Aragya1642/Zoe2_PMS/3_Miscellaneous/Data_Logger/logs/bench/zoe2_log_20260417_154733_panels/temperatures.png

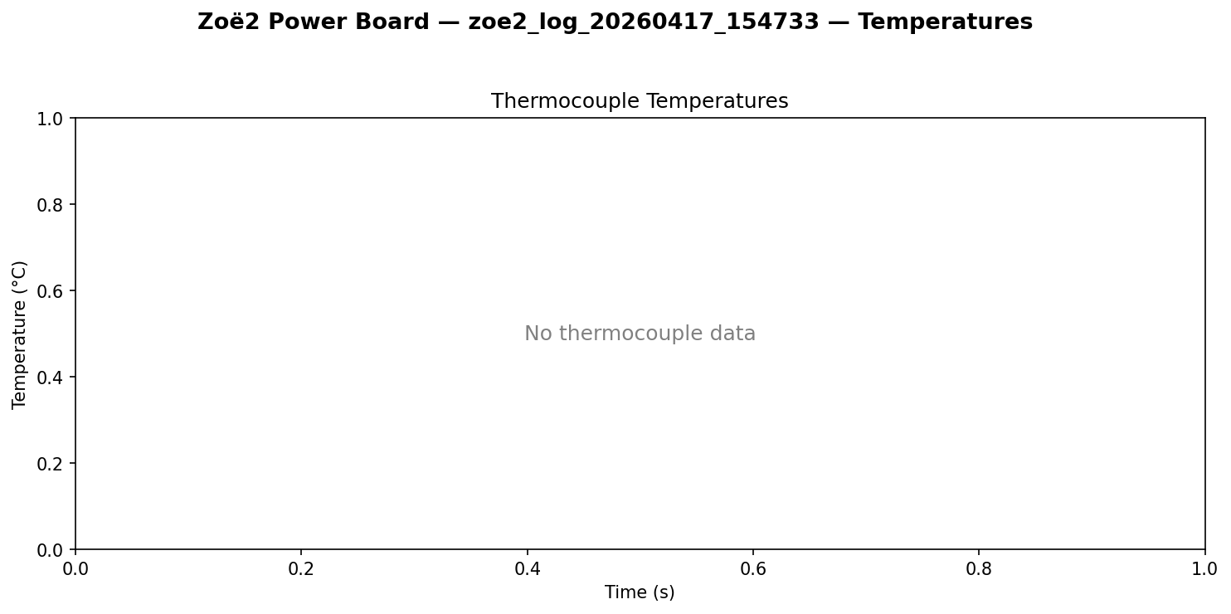
3_Miscellaneous/Data_Logger/logs/bench/zoe2_log_20260417_154733_panels/temperatures.png
