Aragya1642/Zoe2_PMS/3_Miscellaneous/Data_Logger/logs/day1/sun3_panels/currents.png

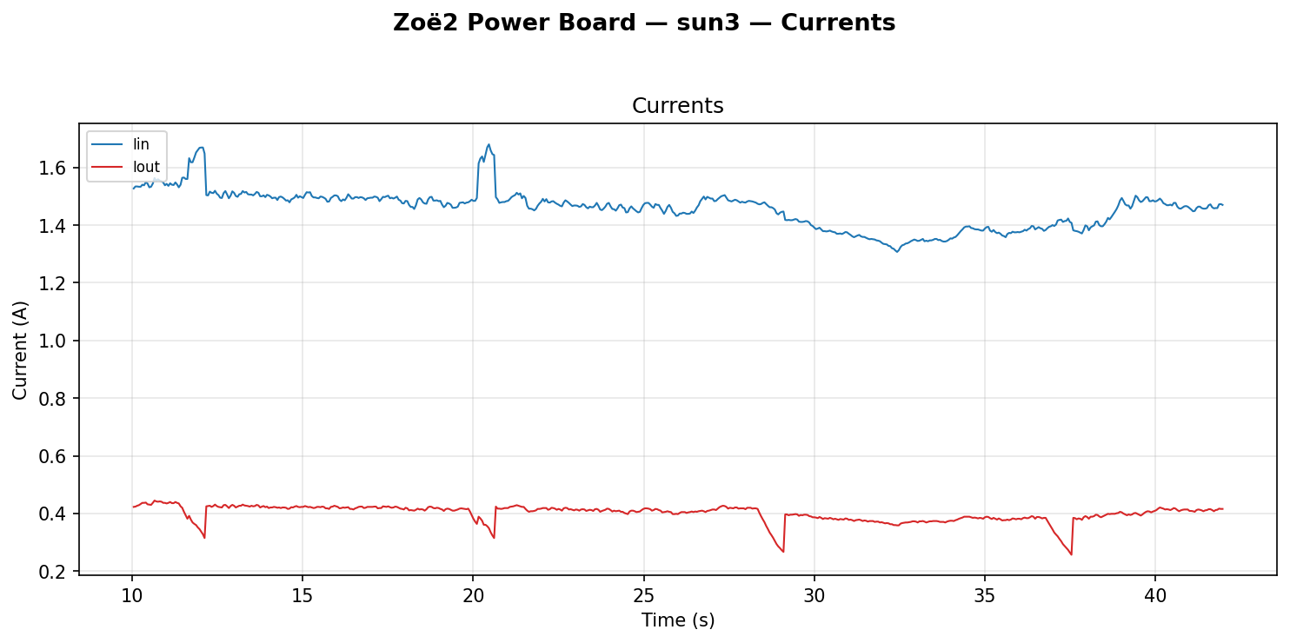
3_Miscellaneous/Data_Logger/logs/day1/sun3_panels/currents.png
