Aragya1642/Zoe2_PMS/2_Embedded/Zoe2_PMS_STM32G4/Core/Src/main.c

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
/* Includes ------------------------------------------------------------------*/
#include "main.h"

/* USER CODE BEGIN Includes */
#include <stdio.h>
#include <string.h>
#include <stdbool.h>
#include <math.h>
#include <ad5245.h>
#include <ads1115.h>
#include <max31855.h>
#include <bms.h>
#include <mppt.h>
#include <safety.h>
#include <ssd1306.h>
#include <ssd1306_fonts.h>
/* USER CODE END Includes */

/* USER CODE BEGIN PD */
/* Set to 1 to enable I2C bus scan at boot (adds ~400 ms delay) */
#define DEBUG_I2C_SCAN    0

/* Set to 1 to enable verbose BMS bring-up debug prints.
 * Keep enabled during hardware bring-up; turn off once BMS is trusted. */
#define DEBUG_BMS         1
/* USER CODE END PD */

FDCAN_HandleTypeDef hfdcan1;
FDCAN_HandleTypeDef hfdcan2;

I2C_HandleTypeDef hi2c2;

SPI_HandleTypeDef hspi1;

UART_HandleTypeDef huart3;

PCD_HandleTypeDef hpcd_USB_FS;

/* USER CODE BEGIN PV */
static const uint16_t channels[] = {
    ADS1115_MUX_SINGLE_0,
    ADS1115_MUX_SINGLE_1,
    ADS1115_MUX_SINGLE_2,
    ADS1115_MUX_SINGLE_3,
};

#define NUM_CHANNELS  (sizeof(channels) / sizeof(channels[0]))

/* ADS1115 runtime config (mux updated per-channel in read_adc) */
static ADS1115_Config cfg;

/* Latest thermocouple readings, cached for OLED and safety module.
 * Each TC has a value and a "last good" timestamp (HAL tick ms).
 * Readings older than TC_STALE_MS are considered stale.
 * Initial ts=0 means "never read" — treated as stale. */
#define TC_STALE_MS   3000u   /* 3x the 1000 ms read period */
static float    g_tc_C[3]     = { 0.0f, 0.0f, 0.0f };
static uint32_t g_tc_last[3]  = { 0, 0, 0 };
/* USER CODE END PV */

void SystemClock_Config(void);
static void MX_GPIO_Init(void);
static void MX_FDCAN1_Init(void);
static void MX_FDCAN2_Init(void);
static void MX_I2C2_Init(void);
static void MX_SPI1_Init(void);
static void MX_USB_PCD_Init(void);
static void MX_USART3_UART_Init(void);
/* USER CODE BEGIN PFP */
static void read_adc(float *v_in, float *i_in, float *v_out, float *i_out);
static void read_thermocouples(void);
static void print_telemetry(const MPPT_Data_t *m);
static void update_oled(const MPPT_Data_t *m);
static void boost_master_enable(bool on);
static void boost_slave_enable(bool on);
static void boost_disable_all(void);
#if DEBUG_BMS
static void bms_debug_summary(void);
#endif
/* USER CODE END PFP */

/* USER CODE BEGIN 0 */
// Allows for you to do printf statements
int _write(int file, char *ptr, int len) {
    HAL_UART_Transmit(&huart3, (uint8_t *)ptr, len, HAL_MAX_DELAY);
    return len;
}

/**
 * @brief Read all four ADS1115 channels and convert to engineering units.
 *
 * Channel mapping:
 *   AIN0 -> input current  (50x gain, 2.5 mOhm shunt)
 *   AIN1 -> output current (50x gain, 2.5 mOhm shunt)
 *   AIN2 -> input voltage  (1:20 divider)
 *   AIN3 -> output voltage (1:20 divider)
 *
 * On I2C error the corresponding output is left at 0.
 */
static void read_adc(float *v_in, float *i_in, float *v_out, float *i_out)
{
    int16_t raw;
    *v_in = *i_in = *v_out = *i_out = 0.0f;

    for (uint8_t ch = 0; ch < NUM_CHANNELS; ch++) {
        cfg.mux = channels[ch];
        if (ADS1115_ReadSingleShot(&hi2c2, ADS1115_ADDR_GND, &cfg, &raw) == HAL_OK) {
            float mv = ADS1115_ConvertToMillivolts(raw, cfg.pga);
            switch (ch) {
                case 0: *i_in  = (mv / 1000.0f / 50.0f) / 0.0025f; break;
                case 1: *i_out = (mv / 1000.0f / 50.0f) / 0.0025f; break;
                case 2: *v_in  = mv / 1000.0f * 20.0f;             break;
                case 3: *v_out = mv / 1000.0f * 20.0f;             break;
            }
        }
    }
}

/**
 * @brief Read all three MAX31855 thermocouples and update the cache.
 *
 * Wiring note (historical): CS1 drives J_Temp3, CS2 drives J_Temp2,
 * CS3 drives J_Temp1. This helper presents them as TC1/TC2/TC3 in
 * the cache to match physical labels.
 *
 * On success, the reading and HAL tick are written to g_tc_C[] and
 * g_tc_last[]. On SPI error or sensor fault the entry is left alone
 * — update_oled() will age out via TC_STALE_MS and display "---".
 */
static void read_thermocouples(void)
{
    /* Mapping: cache index -> (GPIO port, pin) */
    static const struct {
        GPIO_TypeDef *port;
        uint16_t      pin;
    } tc_cs[3] = {
        { GPIOD,                 THERMO_CS3_Pin },   /* TC1 */
        { GPIOD,                 THERMO_CS2_Pin },   /* TC2 */
        { THERMO_CS1_GPIO_Port,  THERMO_CS1_Pin },   /* TC3 */
    };

    uint32_t now = HAL_GetTick();
    MAX31855_Data tc;

    for (uint8_t i = 0; i < 3; i++) {
        if (MAX31855_Read(&hspi1, tc_cs[i].port, tc_cs[i].pin, &tc) == HAL_OK
            && !tc.fault) {
            g_tc_C[i]    = tc.tc_temp;
            g_tc_last[i] = now;
            printf("TC%u: %.2f C  |  CJ%u: %.2f C\r\n",
                   i + 1, tc.tc_temp, i + 1, tc.cj_temp);
        } else {
            printf("TC%u: read failed or faulted\r\n", i + 1);
        }
    }
}

/**
 * @brief Print one MPPT telemetry record to the debug UART.
 */
static void print_telemetry(const MPPT_Data_t *m)
{
    printf("MPPT: tick=%lu  wiper=%u  state=%d  Pin=%.2fW  Vin=%.2fV  Iin=%.3fA\r\n",
           HAL_GetTick(), m->wiper, m->state,
           m->power_W, m->in_voltage_V, m->in_current_A);
    printf("      Vout=%.2fV  Iout=%.3f A\r\n",
           m->out_voltage_V, m->out_current_A);
    printf("----\r\n");
}

/**
 * @brief Render telemetry to a dual-color SSD1306 OLED.
 *
 * Display physically has yellow pixels on rows 0-15 and white/blue
 * pixels on rows 16-63. Layout exploits this split:
 *
 *   YELLOW BAND (y=0..15):
 *     y=3    "PMS         TRACK"  Font_7x10 (18 chars, 10px tall)
 *            — when safety trips, the tag replaces the MPPT state.
 *
 *   WHITE AREA (y=16..63):
 *     y=18   "Pin  : 39.3 W"
 *     y=27   "Pout : 29.0 W"
 *     y=36   "Eff  :  78 %"
 *     y=45   "TC1:45 TC2:42 TC3:68"
 *     y=54   "W:230"
 *
 * Frame push takes ~20-25 ms @ 400 kHz I2C. Call no faster than 500 ms.
 */
static void update_oled(const MPPT_Data_t *m)
{
    static const char *state_names[] = { "IDLE", "TRACK", "SCAN", "FAULT" };
    char buf[24];

    ssd1306_Fill(Black);

    /* ── YELLOW BAND: project + state (or safety tag if faulted) ─ */
    const char *safety_tag = Safety_FaultTag();
    const char *header = (safety_tag[0] != '\0')
                       ? safety_tag
                       : ((m->state <= 3) ? state_names[m->state] : "???");

    /* Font_7x10 is 7px wide → 18 chars fit in 128px width.
     * Pad so state/tag lands right-justified in the yellow strip. */
    snprintf(buf, sizeof(buf), "PMS%*s", 15 - (int)strlen(header), header);
    ssd1306_SetCursor(0, 3);
    ssd1306_WriteString(buf, Font_7x10, White);

    /* ── WHITE AREA: power, efficiency, temperatures ────────────── */

    /* Input power */
    snprintf(buf, sizeof(buf), "Pin  : %5.1f W", m->power_W);
    ssd1306_SetCursor(0, 18);
    ssd1306_WriteString(buf, Font_6x8, White);

    /* Output power */
    float p_out = m->out_voltage_V * m->out_current_A;
    snprintf(buf, sizeof(buf), "Pout : %5.1f W", p_out);
    ssd1306_SetCursor(0, 27);
    ssd1306_WriteString(buf, Font_6x8, White);

    /* Efficiency */
    int eff = 0;
    if (m->power_W > 0.5f) {
        float e = 100.0f * p_out / m->power_W;
        if (e < 0.0f)   e = 0.0f;
        if (e > 150.0f) e = 150.0f;
        eff = (int)e;
    }
    snprintf(buf, sizeof(buf), "Eff  :  %3d %%", eff);
    ssd1306_SetCursor(0, 36);
    ssd1306_WriteString(buf, Font_6x8, White);

    /* Three thermocouples — show "---" if reading is stale or never taken */
    uint32_t now = HAL_GetTick();
    char tc_s[3][4];  /* "-45" or "---" */
    for (uint8_t i = 0; i < 3; i++) {
        bool never = (g_tc_last[i] == 0);
        bool stale = (!never) && (now - g_tc_last[i] > TC_STALE_MS);
        if (never || stale) {
            snprintf(tc_s[i], sizeof(tc_s[i]), "---");
        } else {
            snprintf(tc_s[i], sizeof(tc_s[i]), "%3d", (int)g_tc_C[i]);
        }
    }
    snprintf(buf, sizeof(buf), "T1:%s T2:%s T3:%s",
             tc_s[0], tc_s[1], tc_s[2]);
    ssd1306_SetCursor(0, 45);
    ssd1306_WriteString(buf, Font_6x8, White);

    /* Wiper bottom line */
    snprintf(buf, sizeof(buf), "W:%3u", m->wiper);
    ssd1306_SetCursor(0, 54);
    ssd1306_WriteString(buf, Font_6x8, White);

    ssd1306_UpdateScreen();
}

/**
 * @brief Enable or disable the master boost converter stage.
 *
 * SD_Master  HIGH = enabled (device active)
 * SWEN_Master HIGH = switching enabled
 *
 * Both must be HIGH for the stage to deliver power.
 */
static void boost_master_enable(bool on)
{
    GPIO_PinState state = on ? GPIO_PIN_SET : GPIO_PIN_RESET;
    HAL_GPIO_WritePin(GPIOD, SD_Master_Pin,   state);
    HAL_GPIO_WritePin(GPIOD, SWEN_Master_Pin, state);
}

/**
 * @brief Enable or disable the slave boost converter stage.
 */
static void boost_slave_enable(bool on)
{
    GPIO_PinState state = on ? GPIO_PIN_SET : GPIO_PIN_RESET;
    HAL_GPIO_WritePin(GPIOD, SD_Slave_Pin,   state);
    HAL_GPIO_WritePin(GPIOD, SWEN_Slave_Pin, state);
}

/**
 * @brief Force both boost stages off. Safe default and fault response.
 */
static void boost_disable_all(void)
{
    boost_master_enable(false);
    boost_slave_enable(false);
}

#if DEBUG_BMS
/**
 * @brief Dump parsed BMS telemetry to the UART for bring-up verification.
 *
 * Prints a two-line summary: pack-level info (V/I/SoC) and per-cell
 * statistics (min/max/spread). Only prints if the BMS has produced at
 * least one valid parse (@c valid == true).
 */
static void bms_debug_summary(void)
{
    const BMS_Data_t *b = BMS_GetData();
    if (!b->valid) {
        printf("BMS: no data yet  rx_total=%lu\r\n", b->rx_total);
        return;
    }

    printf("BMS pack: V=%.2fV  I=%.2fA  SoC=%.1f%%  age=%lu ms\r\n",
           b->total0.pack_voltage_V,
           b->total0.current_A,
           b->total0.soc_pct,
           HAL_GetTick() - b->last_update_ms);

    printf("     max=%umV (c%u)  min=%umV (c%u)  diff=%umV  cells=%u\r\n",
           b->cell_stats.max_mv, b->cell_stats.max_cell,
           b->cell_stats.min_mv, b->cell_stats.min_cell,
           b->cell_stats.diff_mv,
           b->status2.cell_number);
}
#endif
/* USER CODE END 0 */

/**
  * @brief  The application entry point.
  * @retval int
  */
int main(void)
{

  /* MCU Configuration--------------------------------------------------------*/

  /* Reset of all peripherals, Initializes the Flash interface and the Systick. */
  HAL_Init();

  /* Configure the system clock */
  SystemClock_Config();

  /* Initialize all configured peripherals */
  MX_GPIO_Init();
  MX_FDCAN1_Init();
  MX_FDCAN2_Init();
  MX_I2C2_Init();
  MX_SPI1_Init();
  MX_USB_PCD_Init();
  MX_USART3_UART_Init();
  /* USER CODE BEGIN 2 */
  printf("alive\r\n");

#if DEBUG_I2C_SCAN
  printf("Scanning I2C2...\r\n");
  for (uint8_t addr = 0x08; addr < 0x78; addr++) {
      if (HAL_I2C_IsDeviceReady(&hi2c2, (addr << 1), 3, 10) == HAL_OK) {
          printf("  Found device at 0x%02X\r\n", addr);
      }
  }
  printf("Done.\r\n");
#endif

  /* ---- ADS1115 configuration ---- */
  cfg.mux       = ADS1115_MUX_SINGLE_0;
  cfg.pga       = ADS1115_PGA_4_096V;
  cfg.mode      = ADS1115_MODE_SINGLE;
  cfg.dr        = ADS1115_DR_128SPS;
  cfg.comp_mode = ADS1115_COMP_MODE_TRAD;
  cfg.comp_pol  = ADS1115_COMP_POL_LOW;
  cfg.comp_lat  = ADS1115_COMP_LAT_OFF;
  cfg.comp_que  = ADS1115_COMP_QUE_DISABLE;

  /* ---- Boost converters start in OFF state ----
   * Explicit safe default: both master and slave disabled at boot.
   * The safety module owns enable/disable from this point forward;
   * boost_master_enable() is called once below after init, then only
   * toggled in response to safety state transitions in the main loop.
   */
  boost_disable_all();
  HAL_Delay(10);

  /* ---- Initialize BMS driver (BEFORE HAL_FDCAN_Start) ----
   * BMS_Init configures an extended-ID filter and enables the RX FIFO0
   * new-message notification. Both calls are only valid while FDCAN is
   * in init mode, so this MUST precede HAL_FDCAN_Start().
   */
  if (BMS_Init(&hfdcan2) != HAL_OK) {
      printf("BMS_Init FAILED\r\n");
  } else {
      printf("BMS initialized\r\n");
  }

  /* ---- Start FDCAN2 ---- */
  if (HAL_FDCAN_Start(&hfdcan2) != HAL_OK) {
      printf("FDCAN2 start FAILED\r\n");
  } else {
      printf("FDCAN2 started OK\r\n");
      /* Send initial wake-up query — BMS begins autonomous broadcast after this */
      if (BMS_SendQuery() != HAL_OK) {
          printf("BMS wake-up query FAILED\r\n");
      } else {
          printf("BMS wake-up query sent\r\n");
      }
  }

  /* ---- Initialize MPPT ---- */
  MPPT_Config_t mppt_cfg = {
      .wiper_min     = 112,
      .wiper_max     = 255,
      .po_step       = 1,
      .scan_step     = 5,
      .scan_interval = MPPT_SCAN_INTERVAL_DEFAULT,
  };
  MPPT_Init(&mppt_cfg);
  printf("MPPT initialized\r\n");

  /* ---- Initialize Safety ---- */
  Safety_Config_t safety_cfg = {
      .vin_max_V      = SAFETY_DEFAULT_VIN_MAX_V,
      .vin_min_V      = SAFETY_DEFAULT_VIN_MIN_V,
      .iin_max_A      = SAFETY_DEFAULT_IIN_MAX_A,
      .vout_max_V     = SAFETY_DEFAULT_VOUT_MAX_V,
      .iout_max_A     = SAFETY_DEFAULT_IOUT_MAX_A,
      .temp_max_C     = SAFETY_DEFAULT_TEMP_MAX_C,
      .tc_stale_ms    = SAFETY_DEFAULT_TC_STALE_MS,
      .bms_timeout_ms = SAFETY_DEFAULT_BMS_TIMEOUT_MS,
      .recovery_ms    = SAFETY_DEFAULT_RECOVERY_MS,
  };
  Safety_Init(&safety_cfg);
  printf("Safety initialized\r\n");

  /* ---- Initialize OLED ---- */
  ssd1306_Init();
  ssd1306_Fill(Black);
  ssd1306_SetCursor(10, 24);
  ssd1306_WriteString("Booting...", Font_11x18, White);
  ssd1306_UpdateScreen();
  HAL_Delay(500);
  printf("OLED initialized\r\n");

  /* ---- All subsystems ready — enable master boost stage ----
   * Main loop will disable the boost if safety reports SHUTDOWN
   * and re-enable it when safety returns to SAFE after recovery.
   */
  boost_master_enable(true);
  printf("Boost master enabled\r\n");

  /* USER CODE END 2 */

  /* Infinite loop */
  /* USER CODE BEGIN WHILE */
  while (1)
  {
    /* USER CODE END WHILE */

    /* USER CODE BEGIN 3 */
      /* ── Heartbeat LEDs ───────────────────────────────────────── */
      HAL_GPIO_TogglePin(GPIOG, CAN_NMT_STATUS_Pin);
      HAL_GPIO_TogglePin(GPIOG, CAN_ERROR_STATE_Pin);

      /* ── MPPT + ADC + safety check + telemetry (every 50 ms) ──── */
      static uint32_t last_mppt = 0;
      if (HAL_GetTick() - last_mppt >= 50) {
          last_mppt = HAL_GetTick();

          float v_in, i_in, v_out, i_out;
          read_adc(&v_in, &i_in, &v_out, &i_out);

          /* Pull latest BMS data. last_update_ms and valid are updated
           * asynchronously from the FDCAN RX ISR; 32-bit reads are atomic
           * on STM32G4 so no critical section is needed. */
          const BMS_Data_t *bms = BMS_GetData();

          /* Safety evaluates *before* MPPT so we never drive the pot
           * with a value from a cycle that turned out to be faulted. */
          Safety_Inputs_t si = {
              .v_in          = v_in,
              .i_in          = i_in,
              .v_out         = v_out,
              .i_out         = i_out,
              .tc_C          = g_tc_C,
              .tc_last       = g_tc_last,
              .bms_last_tick = bms->last_update_ms,
              .bms_enabled   = bms->valid,  /* auto-enables on first frame */
          };
          Safety_Response_t rsp = Safety_Check(&si);

          if (rsp == SAFETY_SHUTDOWN) {
              /* Kill the boost and skip MPPT. The algorithm state is
               * preserved — when we recover, P&O picks up where it left
               * off rather than starting fresh. */
              boost_disable_all();
          } else {
              /* Re-enable on the first cycle after recovery; cheap
               * GPIO write so calling it every cycle is fine. */
              boost_master_enable(true);

              uint8_t wiper = MPPT_Step(v_in, i_in, v_out, i_out);
              AD5245_SetWiper(&hi2c2, AD5245_ADDR_AD0_LOW, wiper);
          }

          print_telemetry(MPPT_GetData());
      }

      /* ── OLED update (every 500 ms) ───────────────────────────── */
      static uint32_t last_oled = 0;
      if (HAL_GetTick() - last_oled >= 500) {
          last_oled = HAL_GetTick();
          update_oled(MPPT_GetData());
      }

      /* ── Thermocouple reads (every 1 s) ───────────────────────── */
      static uint32_t last_tc = 0;
      if (HAL_GetTick() - last_tc >= 1000) {
          last_tc = HAL_GetTick();
          read_thermocouples();

    	  /* Keep fake cache fresh so TC_STALE never trips */
//		  uint32_t now = HAL_GetTick();
//		  g_tc_C[0]    = 25.0f;
//		  g_tc_last[0] = now;
//		  g_tc_C[1]    = 25.0f;
//		  g_tc_last[1] = now;
//		  g_tc_C[2]    = 25.0f;
//		  g_tc_last[2] = now;
      }

      /* ── BMS Keepalive (every 2.5 s) ──────────────────────────── */
      static uint32_t last_bms = 0;
      if (HAL_GetTick() - last_bms >= BMS_KEEPALIVE_MS) {
          last_bms = HAL_GetTick();
          HAL_StatusTypeDef s = BMS_SendQuery();
#if DEBUG_BMS
          printf("BMS query: %s\r\n", (s == HAL_OK) ? "OK" : "FAIL");
#else
          if (s != HAL_OK) { printf("BMS_SendQuery FAILED\r\n"); }
#endif
      }

#if DEBUG_BMS
      /* ── BMS liveness + parsed-data dump (every 2 s) ──────────── */
      static uint32_t last_bms_dbg = 0;
      if (HAL_GetTick() - last_bms_dbg >= 2000) {
          last_bms_dbg = HAL_GetTick();

          const BMS_Data_t *b = BMS_GetData();
          uint32_t age = b->last_update_ms
                       ? (HAL_GetTick() - b->last_update_ms) : 0;
          printf("BMS: valid=%d  rx_total=%lu  age=%lu ms\r\n",
                 b->valid, b->rx_total, age);

          bms_debug_summary();
      }
#endif

  }

  /* USER CODE END 3 */
}

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
/* USER CODE BEGIN 4 */

/**
 * @brief FDCAN RX FIFO0 callback — HAL requires this at application
 *        level. Delegates to the appropriate driver based on which
 *        FDCAN peripheral triggered the interrupt.
 */
void HAL_FDCAN_RxFifo0Callback(FDCAN_HandleTypeDef *hfdcan,
                               uint32_t RxFifo0ITs)
{
    if (hfdcan == &hfdcan2) {
        BMS_RxCallback(hfdcan);
    }
    /* FDCAN1 (CANopen) RX handler would go here when added */
}

/* USER CODE END 4 */
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
