Aragya1642/Zoe2_PMS/2_Embedded/Zoe2_PMS_STM32G4/Zoe2_PMS_STM32G4.ioc

Mcu.UserName=STM32G473QETx
PA11.Signal=USB_DM
PA12.Signal=USB_DP
PA13.Signal=SYS_JTMS-SWDIO
PA14.Signal=SYS_JTCK-SWCLK
PA7.Signal=SPI1_MOSI
PA8.Signal=I2C2_SDA
PB12.Signal=FDCAN2_RX
PB4.Signal=SPI1_MISO
PB6.Signal=FDCAN2_TX
PB9.Signal=USART3_TX
PC10.Signal=GPIO_Input
PC11.Signal=USART3_RX
PC4.Signal=I2C2_SCL
PC8.GPIO_Label=THERMO_CS1
PC8.Signal=GPIO_Output
PD0.Signal=FDCAN1_RX
PD1.Signal=FDCAN1_TX
PD2.GPIO_Label=THERMO_CS2
PD2.Signal=GPIO_Output
PD3.GPIO_Label=THERMO_CS3
PD3.Signal=GPIO_Output
PD4.GPIO_Label=SWEN_Master
PD4.Signal=GPIO_Output
PD5.GPIO_Label=SWEN_Slave
PD5.Signal=GPIO_Output
PD6.GPIO_Label=SD_Master
PD6.Signal=GPIO_Output
PD7.GPIO_Label=SD_Slave
PD7.Signal=GPIO_Output
PE0.Signal=GPIO_Output
PE1.Signal=GPIO_Output
PE2.Signal=GPIO_Output
PE3.Signal=GPIO_Output
PE4.Signal=GPIO_Input
PF0-OSC_IN.Signal=RCC_OSC_IN
PF1-OSC_OUT.Signal=RCC_OSC_OUT
PF3.Signal=GPIO_Output
PF4.Signal=GPIO_Output
PF5.Signal=GPIO_Output
PF7.Signal=GPIO_Output
PG0.GPIO_Label=CAN_NMT_STATUS
PG0.Signal=GPIO_Output
PG1.GPIO_Label=CAN_ERROR_STATE
PG1.Signal=GPIO_Output
PG2.Signal=SPI1_SCK
PG3.Signal=GPIO_Input
PG4.Signal=GPIO_Input
PG5.Signal=GPIO_Input
PG6.Signal=GPIO_Input
PG7.Signal=GPIO_Output
PG8.Signal=GPIO_Output
PG9.Signal=GPIO_Output
