Aragya1642/Zoe2_PMS/2_Embedded/STM32L4_CANOpen/Core/Src/main.c

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
/* Includes ------------------------------------------------------------------*/
#include "main.h"

/* USER CODE BEGIN Includes */
#include <stdio.h>
#include "CO_app_STM32.h"
#include "OD.h"
/* USER CODE END Includes */

CAN_HandleTypeDef hcan1;

TIM_HandleTypeDef htim7;

UART_HandleTypeDef huart2;

void SystemClock_Config(void);
static void MX_GPIO_Init(void);
static void MX_CAN1_Init(void);
static void MX_TIM7_Init(void);
static void MX_USART2_UART_Init(void);
/* USER CODE BEGIN 0 */
int _write(int file, char *ptr, int len)
{
  HAL_UART_Transmit(&huart2, (uint8_t *)ptr, len, HAL_MAX_DELAY);
  return len;
}
/* USER CODE END 0 */

/**
  * @brief  The application entry point.
  * @retval int
  */
int main(void)
{

  /* MCU Configuration--------------------------------------------------------*/

  /* Reset of all peripherals, Initializes the Flash interface and the Systick. */
  HAL_Init();

  /* Configure the system clock */
  SystemClock_Config();

  /* Initialize all configured peripherals */
  MX_GPIO_Init();
  MX_CAN1_Init();
  MX_TIM7_Init();
  MX_USART2_UART_Init();
  /* USER CODE BEGIN 2 */
  CANopenNodeSTM32 canopenNodeSTM32;				// Create CANOpen Node Instance Struct
  canopenNodeSTM32.CANHandle = &hcan1;				// Pass in CAN Object peripheral handle
  canopenNodeSTM32.HWInitFunction = MX_CAN1_Init;	// Function pointer for re initialization
  canopenNodeSTM32.timerHandle = &htim7;			// 1ms timer handle for CANOpen protocol timing
  canopenNodeSTM32.desiredNodeID = 32;				// This node's ID (1-127) - must be unique on the bus
  canopenNodeSTM32.baudrate = 1000;					// CAN bus speed in kbps - must match the bit timing in configuration
  canopen_app_init(&canopenNodeSTM32);				// Initialize the full CANOpen Stack
  /* USER CODE END 2 */

  /* Infinite loop */
  /* USER CODE BEGIN WHILE */
  while (1)
  {
	  // Make sure to add the LED outputs for CAN Status - this is in the tutorial.
	  canopen_app_process();

	  OD_PERSIST_COMM.x6000_counter++;	// This is how you access raw OD variables in the memory

	  OD_set_u32(OD_find(OD, 0x6000), 0x00, 123, false);	// This is a safer way to access variables and set their values

//	  if (OD_PERSIST_COMM.x6000_counter != old_counter){					// This is a good way to do change of state implementation
//		  CO_TPDOsendRequest(&canopenNodeSTM32.canOpenStack->TPDO[0]);		// This manually transmits the first TPDO
//	  }

	  HAL_Delay(10);
    /* USER CODE END WHILE */

    /* USER CODE BEGIN 3 */
  }
  /* USER CODE END 3 */
}

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
/* USER CODE BEGIN 4 */
void HAL_TIM_PeriodElapsedCallback(TIM_HandleTypeDef *htim)		// Connect the timer interrupt to the TPDO stuff
{
  if (htim == &htim7)
  {
    canopen_app_interrupt();
  }
}
/* USER CODE END 4 */
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
