Aragya1642/Zoe2_PMS/(commit log)

2026-02-22 Added net labels for sensor outputs - abandoning MATLAB sim
2026-02-22 Organization + Added battery data parsing script
2026-02-22 Working LED Blink on L4 board
2026-02-23 Add handlers for more battery data types
2026-02-24 Basic Arduino setup for validation
2026-02-24 Working I2C validation scripts between Mega and Uno
2026-02-25 Basic SPI framework setup
2026-02-25 Working SPI comms between Uno and Mega
2026-02-25 Starts setup for I2C and SPI on L4 board
2026-02-26 Working I2C and SPI from STM32 -> Arduino Mega
2026-03-14 working ad5245 at 3.3v Vdd
2026-03-20 CANOpen Node software stack runs on L4 device - needs checking with adapter
2026-03-21 Working Object Dictionary implementation with basic change to the device type - Also adds the GUI editor for the Object Dictionary editing
2026-04-01 Initial commit to start development of thermocouple drivers
2026-04-01 Auto settings changes because working on laptop. Initial commit for the thermocouple drivers - needs to be tested
2026-04-03 Whatever is currently on the big board - needs a lot of work
2026-04-04 Validated control of I2C devices on the board - able to get readings from ADC and digital potentiometer
2026-04-06 Moves user code to defined sections, removes i2c1 line as it is flipped and not working, names SWEN and SD pins for master
    [Zoe2_PMS_STM32G4.ioc, main.c, main.h]
2026-04-08 update ioc file for SPI, CAN timing rates - both still need to be made functional
2026-04-11 Working thermocouple code for all - needs pin renaming for CS pins
2026-04-13 bms and mppt control in progresss
2026-04-14 Fixed battery parse script for func=0x02
2026-04-14 finished bms.h, bms.c still WIP
2026-04-14 finished bms implementation
2026-04-17 Ran testing with this code, was able to log and plot the data read by UART
    [zoe2_log_20260416_210404.csv]
2026-04-17 Data at lower voltages
    [zoe2_log_20260417_154733.csv]
2026-04-17 experimental data
    [shaded.csv, sun1.csv]
2026-04-17 sun2 collection
    [sun2.csv]
2026-04-17 sun 3 collection
    [sun3.csv]
2026-04-21 cleaned up code, OLED displaying metrics, UART recieves debugging data
2026-04-21 Implementation of safety algorithms for electrical and temperature conditions
2026-04-21 running testing outdoors field code + log for first test
    [shaded.csv, sun1.csv, sun2.csv, sun3.csv, zoe2_log_20260417_154733.csv, zoe2_log_20260421_152651.csv]
2026-04-21 Sticky voltage display on OLED and new data for fault conditioning
    [input_overcurrent.csv, very_long_video.csv]
2026-04-21 slow global scan for visual
    [slow_scan.csv]
2026-04-21 second slow scan data
    [slow_scan_2.csv]
2026-04-22 FDCAN2 set up for BMS by setting up interrupt and extended filter for the CAN line in the STMCubeMX
2026-04-23 Working comms with BMS
