Aragya1642/Zoe2_PMS/(notices)

Notices in the files:
2_Embedded/Zoe2_PMS_STM32G4/Core/Inc/main.h:
Copyright (c) 2026 STMicroelectronics.
All rights reserved.
This software is licensed under terms that can be found in the LICENSE file
